SlightRecoil/Werkstatten-Sommerprojekt/Documentation/timeline.tex

\documentclass{article}
\usepackage{graphicx}
\begin{document}
This is where im going to save what happened when
25.02.2025: personel allocation was divised, schedule was made, components were found, started drawing circuit
\end{document}
