SlightRecoil/Werkstatten-Sommerprojekt/Documentation/images/helmet1.png

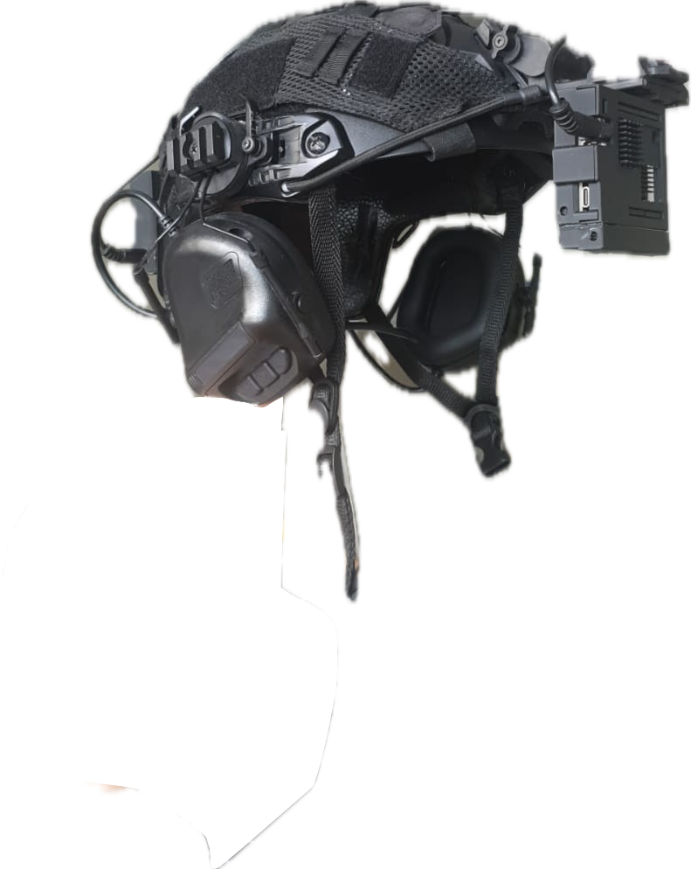
Documentation/images/helmet1.png
