SlightRecoil/Werkstatten-Sommerprojekt/Documentation/images/helmet2.png

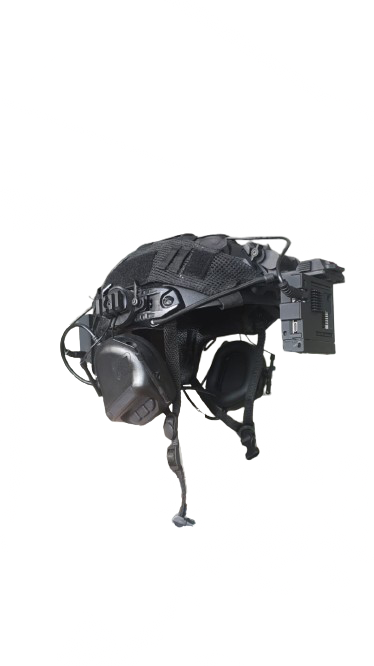
Documentation/images/helmet2.png
