SlightRecoil/Werkstatten-Sommerprojekt/Documentation/images/helmet3.png

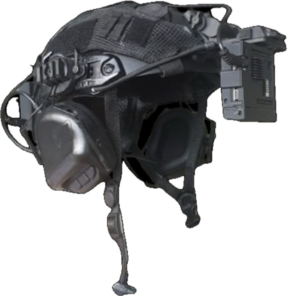
Documentation/images/helmet3.png
