SlightRecoil/Werkstatten-Sommerprojekt/Documentation/images/helmet_bg.jpeg

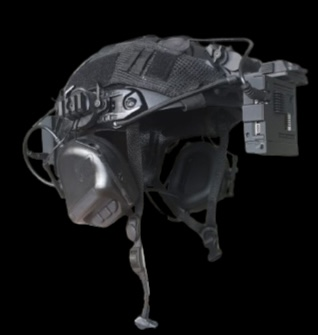
Documentation/images/helmet_bg.jpeg
