SlightRecoil/Werkstatten-Sommerprojekt/Documentation/images/main.png

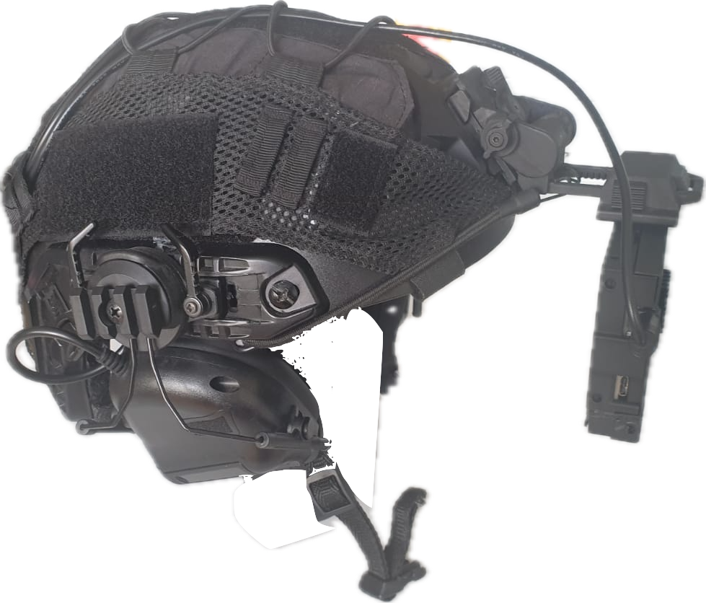
Documentation/images/main.png
