SlightRecoil/Werkstatten-Sommerprojekt/Documentation/m1 subcircuit.png

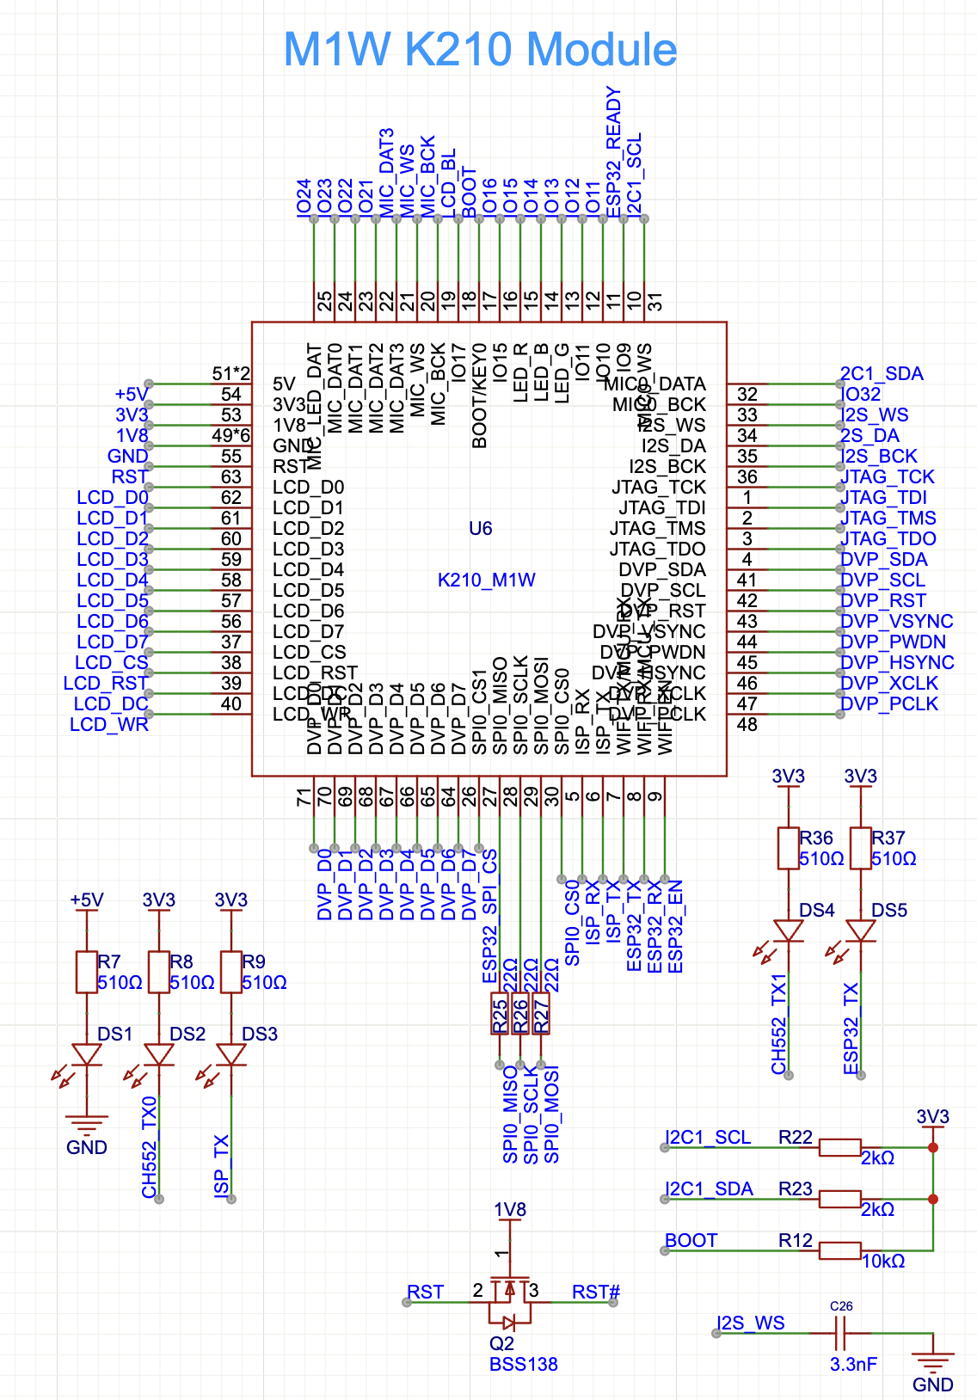
Documentation/m1 subcircuit.png
