SlightRecoil/Werkstatten-Sommerprojekt/PCB/DNOD_BOM.xlsx

No. | Quantity | Comment | Designator | Footprint | Value | Manufacturer Part | Manufacturer | Supplier Part | Supplier
1 | 2 | 100nF | C1,C8 | C0402 | 100nF | CL05B104KO5NNNC | SAMSUNG(三星) | C1525 | LCSC
2 | 2 | 22uF | C2,C13 | CAP-SMD_BD5.0-L5.3-W5.3-FD | 22uF | RVE1E220M0505 | HONOR(荣誉) | C88661 | LCSC
3 | 6 | 100nF | C4,C9,C10,C12,C20,C22 | C0603 | 100nF | CGA0603X7R104K500JT | HRE(芯声) | C6119867 | LCSC
4 | 1 | 10nF | C5 | C0402 | 10nF | CC0402KRX7R9BB103 | YAGEO(国巨) | C60133 | LCSC
5 | 1 | 10uF | C6 | C0805 | 10uF | CL21A106KAYNNNE | SAMSUNG(三星) | C15850 | LCSC
6 | 3 | 22uF | C7,C18,C19 | C0603 | 22uF | CL10A226MQ8NRNC | SAMSUNG(三星) | C59461 | LCSC
7 | 1 | 22uF | C11 | C0603 | 22uF | CL10A226MP8NUNE | SAMSUNG(三星) | C86295 | LCSC
8 | 2 | 10uF | C15,C21 | C0603 | 10uF | CGA0603X5R106K100JT | HRE(芯声) | C6119842 | LCSC
9 | 2 | 18pF | C16,C17 | C0402 | 18pF | FCC0402N180J500AT | FOJAN(富捷) | C5137554 | LCSC
10 | 1 | 3.3nF | C23 | C0402 | 3.3nF | CC0402KRX7R9BB332 | YAGEO(国巨) | C107028 | LCSC
11 | 2 | 10uF | C24,C25 | CAP-SMD_BD6.3-L6.6-W6.6-LS7.2-FD | 10uF | RVT2A100M0607 | HONOR(荣誉) | C86606 | LCSC
12 | 1 | GPIOs | CN1 | FPC-SMD_KH-FG0.5-H2.0-24PIN |  | KH-FG0.5-H2.0-24PIN | kinghelm(金航标) | C2797213 | LCSC
13 | 1 | LCD | CN2 | FPC-SMD_KH-FG0.5-H2.0-24PIN |  | KH-FG0.5-H2.0-24PIN | kinghelm(金航标) | C2797213 | LCSC
14 | 1 | Camera | CN3 | FPC-SMD_KH-FG0.5-H2.0-24PIN |  | KH-FG0.5-H2.0-24PIN | kinghelm(金航标) | C2797213 | LCSC
15 | 2 | DSK24 | D1,D2 | SOD-123FL_L2.7-W1.8-LS3.8-RD |  | DSK24 | TWGMC(台湾迪嘉) | C727073 | LCSC
16 | 5 | XL-1608SURC-06 | DS1,DS2,DS3,DS4,DS5 | LED0603-RD_RED |  | XL-1608SURC-06 | XINGLIGHT(成兴光) | C965799 | LCSC
17 | 1 | MF-NSMF200-2 | F1 | F1206 |  | MF-NSMF200-2 | BOURNS | C89656 | LCSC
18 | 1 | M6027-01 | J1 | TF-SMD_M6027-01 |  | M6027-01 | MUP(德海威) | C20624804 | LCSC
19 | 1 | DC-005-2.0 | J2 | DC-IN-TH_DC-005-2.0_C22459640 |  | DC-005-2.0 | HanElectricity(瀚源) | C22459640 | LCSC
20 | 1 | 6.8uH | L1 | IND-SMD_L2.5-W2.0_YXMBL252010P | 6.8uH | FTC252012S6R8MBCA | cjiang(长江微电) | C5832375 | LCSC
21 | 1 | AO3401A | Q1 | SOT-23-3_L2.9-W1.6-P1.90-LS2.8-BR |  | AO3401A | ElecSuper(静芯微) | C5224202 | LCSC
22 | 1 | BSS138 | Q2 | SOT-23_L2.9-W1.3-P1.90-LS2.4-BR |  | BSS138 | JUXING(钜兴) | C5279927 | LCSC
23 | 6 | 10kΩ | R1,R2,R5,R6,R16,R17 | R0603 | 10kΩ | FRC0603J103TS | FOJAN(富捷) | C2930027 | LCSC
24 | 2 | 1kΩ | R3,R10 | R0402 | 1kΩ | 0402WGF1001TCE | UNI-ROYAL(厚声) | C11702 | LCSC
25 | 1 | 39Ω | R4 | R0402 | 39Ω | RC0402FR-0739RL | YAGEO(国巨) | C185420 | LCSC
26 | 1 | 68kΩ | R7 | R0402 | 68kΩ | RC0402FR-0768KL | YAGEO(国巨) | C137947 | LCSC
27 | 1 | 13kΩ | R8 | R0402 | 13kΩ | RC0402FR-0713KL | YAGEO(国巨) | C138057 | LCSC
28 | 1 | 1.4kΩ | R9 | R0402 | 1.4kΩ | RC-02W1401FT | FH(风华) | C290101 | LCSC
29 | 2 | 1kΩ | R11,R13 | R0402 | 1kΩ | RC0402FR-071KL | YAGEO(国巨) | C106235 | LCSC
30 | 4 | 2kΩ | R12,R14,R18,R21 | R0402 | 2kΩ | RC0402FR-072KL | YAGEO(国巨) | C60488 | LCSC
31 | 1 | 5R3 | R15 | R0603 | 10K
32 | 5 | 510Ω | R19,R20,R22,R23,R24 | R0603 | 510Ω | FRC0603J511 TS | FOJAN(富捷) | C2907179 | LCSC
33 | 6 | 22Ω | R25,R26,R27,R28,R29,R31 | R0402 | 22Ω | RC0402FR-0722RL | YAGEO(国巨) | C114765 | LCSC
34 | 2 | 2kΩ | R30,R32 | R0603 | 2kΩ | 0603WAF2001T5E | UNI-ROYAL(厚声) | C22975 | LCSC
35 | 1 | 10kΩ | R33 | R0603 | 10kΩ | 0603WAF1002T5E | UNI-ROYAL(厚声) | C25804 | LCSC
36 | 1 | NC | R34 | R0603 | 10kΩ | 0603WAF1002T5E | UNI-ROYAL(厚声) | C25804 | LCSC
37 | 1 | 5.1kΩ | R36 | R0402 | 5.1kΩ | 0402WGF5101TCE | UNI-ROYAL(厚声) | C25905 | LCSC
38 | 2 | TS-1088R-02026 | SW1,SW2 | SW-SMD_L3.9-W3.0-P4.45 |  | TS-1088R-02026 | XUNPU(讯普) | C455280 | LCSC
39 | 1 | PT8211-S | U1 | SOP-8_L4.9-W3.9-P1.27-LS6.0-BL |  | PT8211-S | PTC(普诚) | C92004 | LCSC
40 | 1 | LM321 | U2 | SOT-23-5_L3.0-W1.7-P0.95-LS2.8-BL |  | LM321 | PJSEMI(平晶微) | C686636 | LCSC
41 | 2 | AMS1117-ADJ | U3,U6 | SOT-223-3_L6.5-W3.4-P2.30-LS7.0-BR |  | AMS1117-ADJ | YONGYUTAI(永裕泰) | C2891840 | LCSC
42 | 1 | EUP3458VIR1 | U4 | SOT-23-6_L2.9-W1.6-P0.95-LS2.8-BL |  | EUP3458VIR1 | EUTECH(德信) | C89300 | LCSC
43 | 1 | XC6206-3.3V | U5 | SSOT-3_L2.9-W1.6-P0.95-LS2.8-BR |  | XC6206-3.3V | YONGYUTAI(永裕泰) | C2891841 | LCSC
44 | 1 | CH552T | U7 | TSSOP-20_L6.5-W4.4-P0.65-LS6.4-BL |  | CH552T | WCH(南京沁恒) | C111367 | LCSC
45 | 1 | 24MHz | U8 | XTAL_ABM8-24.000MHZ-B2-T
46 | 1 | K210_M1W | U9 | K210_M1W
47 | 1 | AMS1117-3.3 | U10 | SOT-223-3_L6.5-W3.4-P2.30-LS7.0-BR |  | AMS1117-3.3 | YONGYUTAI(永裕泰) | C2891839 | LCSC
48 | 1 | 42pF | U12 | SOT-563_L1.6-W1.2-P0.50-LS1.6-TL | 42pF | NUF2042XV6T1G | onsemi(安森美) | C90707 | LCSC
49 | 1 | ESP32-WROOM-32U-N4 | U20 | WIFI-SMD_ESP32-WROOM-32UE-A |  | ESP32-WROOM-32U-N4 | ESPRESSIF(乐鑫) | C2934572 | LCSC
50 | 1 | TYPE-C16PIN | USB1 | USB-C-SMD_TYPE-C16PIN |  | TYPE-C16PIN | SHOU HAN(首韩) | C393939 | LCSC
