SlightRecoil/Werkstatten-Sommerprojekt/PCB/DNOD_Gerber/How-to-order-PCB.txt

How to Order PCB

Please refer to:
https://prodocs.easyeda.com/en/pcb/order-order-pcb/index.html
