SlightRecoil/Werkstatten-Sommerprojekt/Documentation/designs/subcircuit.pdf

# M1W K210 Module

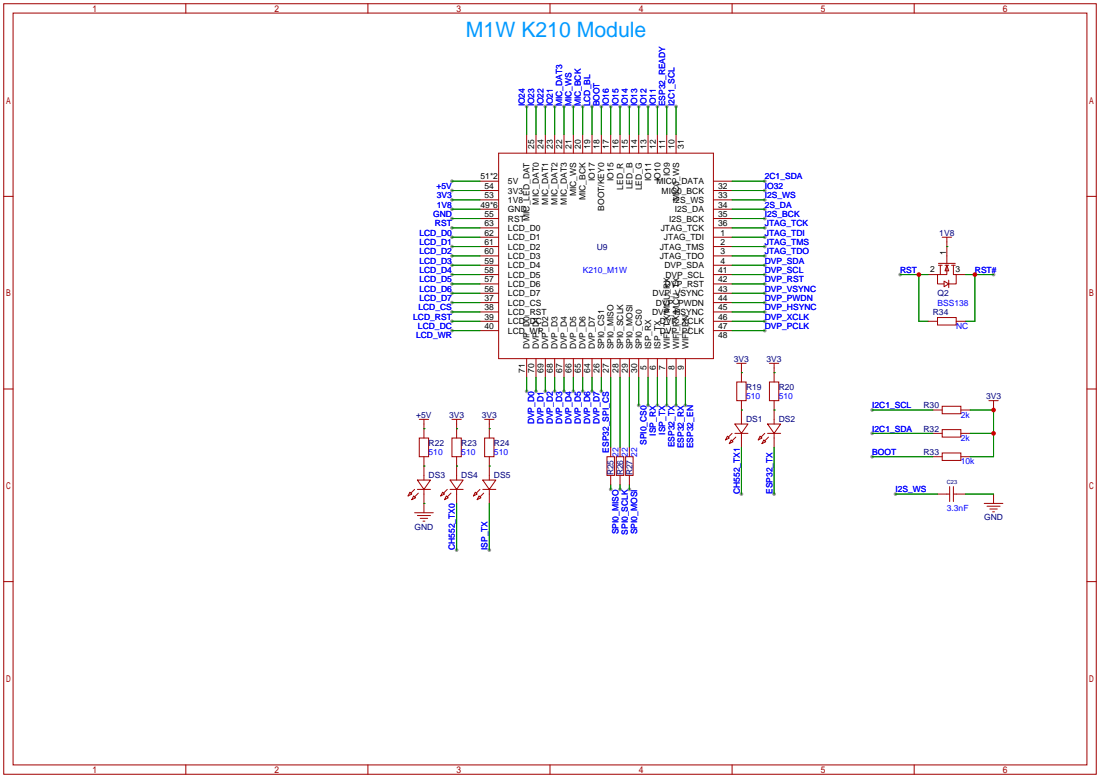
[picture p27: page 1]

# 8 Bit MCU LCD Connector

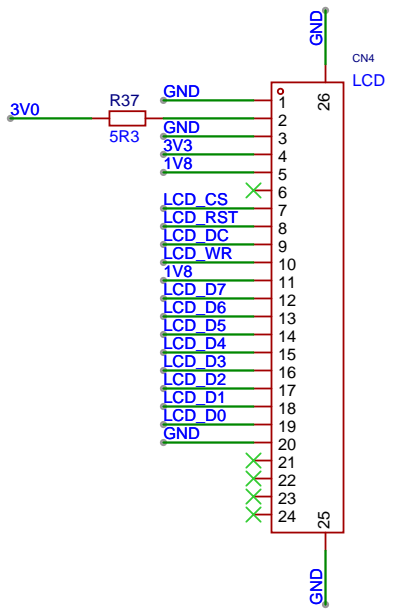
[picture p28: figure]
CN4 LCD; GND; GND 3V3 1V8; LCD_CS LCD_RST LCD_DC LCD_WR 1V8 LCD_D7 LCD_D6 LCD_D5 LCD_D4 LCD_D3 LCD_D2 LCD_D1 LCD_D0 GND; GND GND
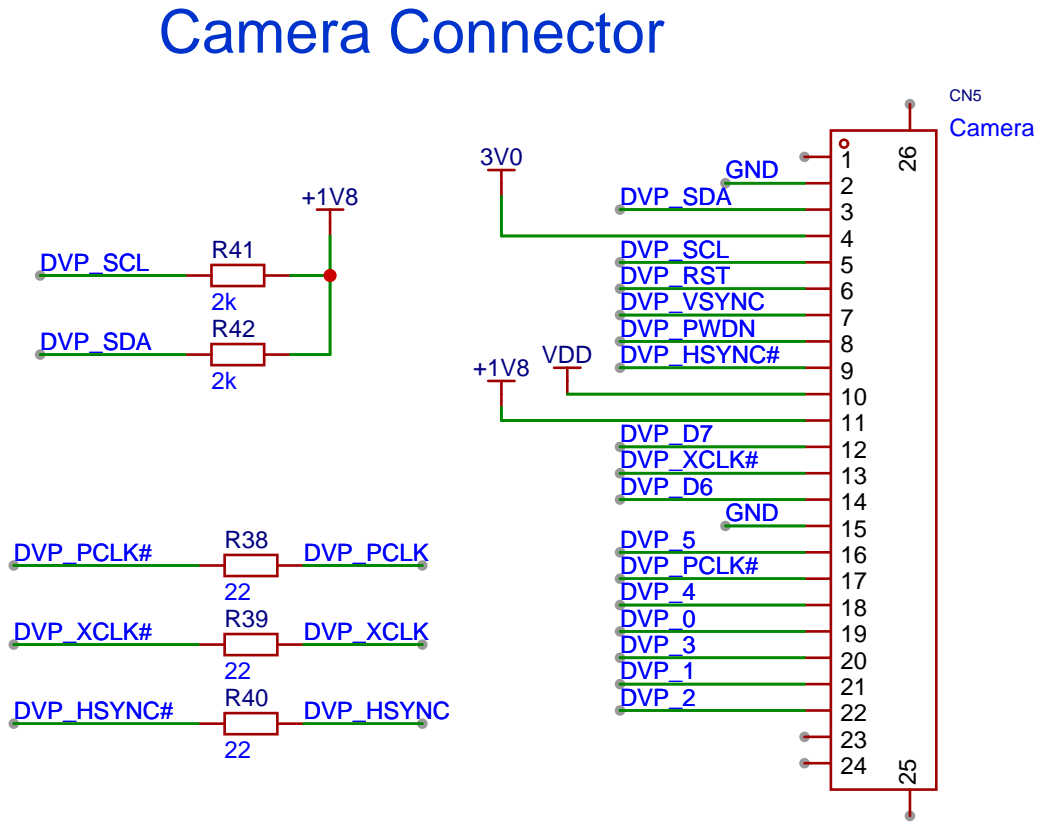
[picture p29: page 3]

# USB-C Port

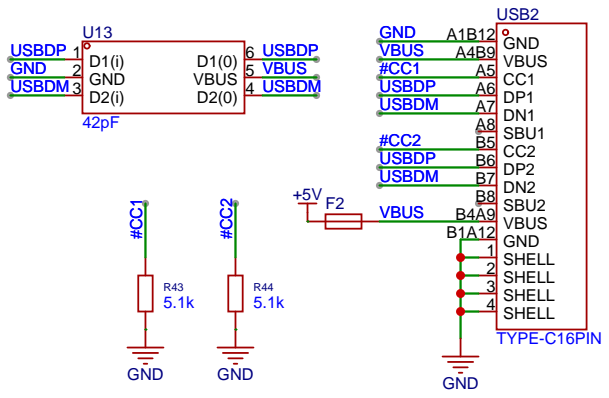
[picture p30: figure]
GND A1B12 VBUS A4B9 CC1 A5 DP1 A6 DN1 A7 SBU1 A8 CC2 B5 DP2 B6 DN2 B7 SBU2 B8 VBUS B4A9 GND B1A12 SHELL 1 SHELL 2 SHELL 3 SHELL 4; USB2; TYPE-C16PIN; GND; USBDP USBDM; GND VBUS #CC1; #CC2 USBDP USBDM; VBUS; D1(i) 1 GND 2 D2(i) 3; VBUS 5; USBDP; USBDM

# GPIOs

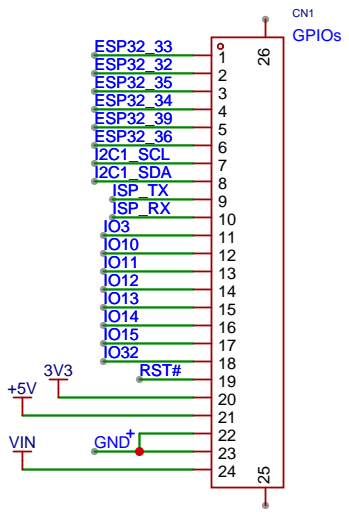
[picture p31: figure]
RST#; ESP32_33 ESP32_32 ESP32_35 ESP32_34 ESP32_39 ESP32_36 I2C1_SCL I2C1_SDA; ISP_TX ISP_RX; VIN; GND; CN1 GPIOs

# SD card slot

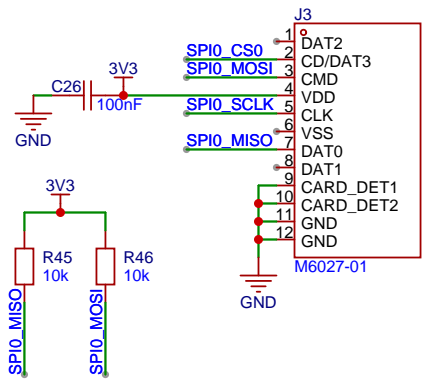
[picture p32: figure]
DAT2 1 CD/DAT3 2 CMD 3 VDD 4 CLK 5 VSS 6 DAT0 7 DAT1 8 CARD_DET1 9 CARD_DET2 10 GND 11 GND 12; SPI0_CS0 SPI0_MOSI; SPI0_SCLK; SPI0_MISO; SPI0_MOSI; GND
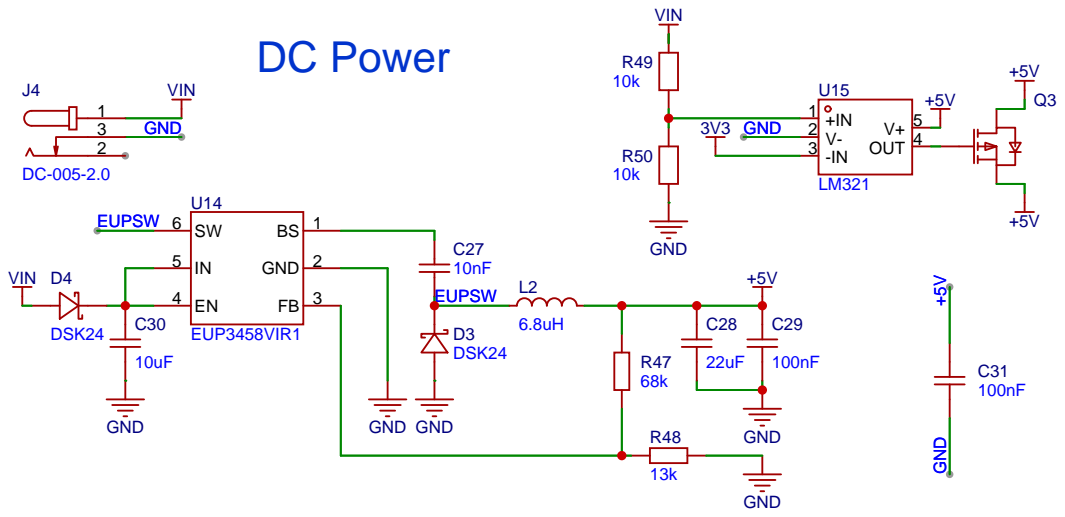
[picture p33: page 7]

# Camera Power

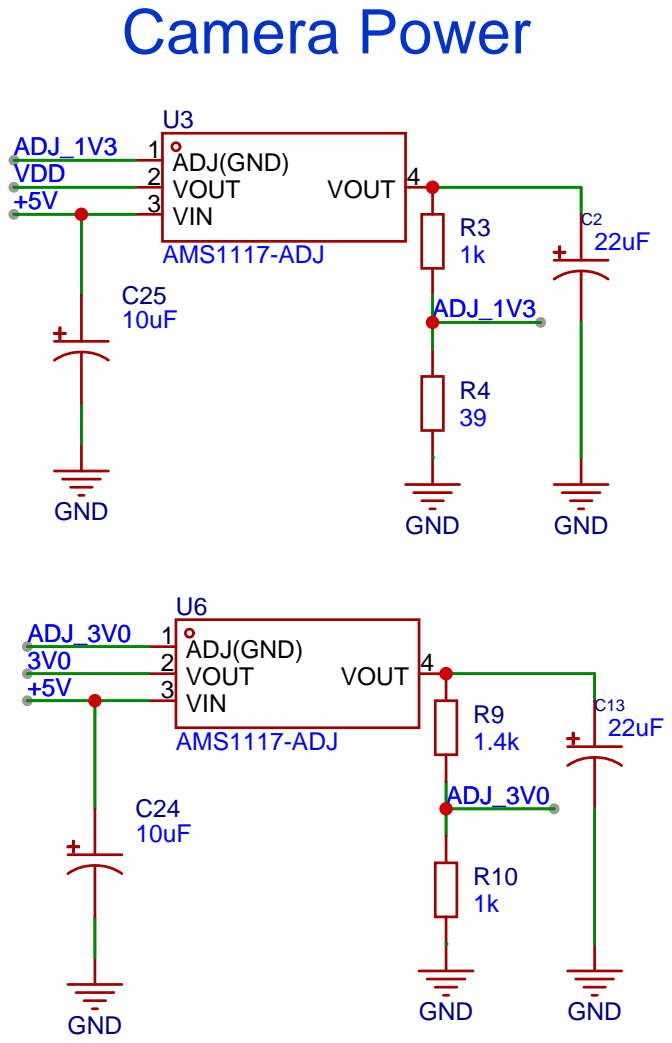
[picture p34: page 8]

# ISP Download

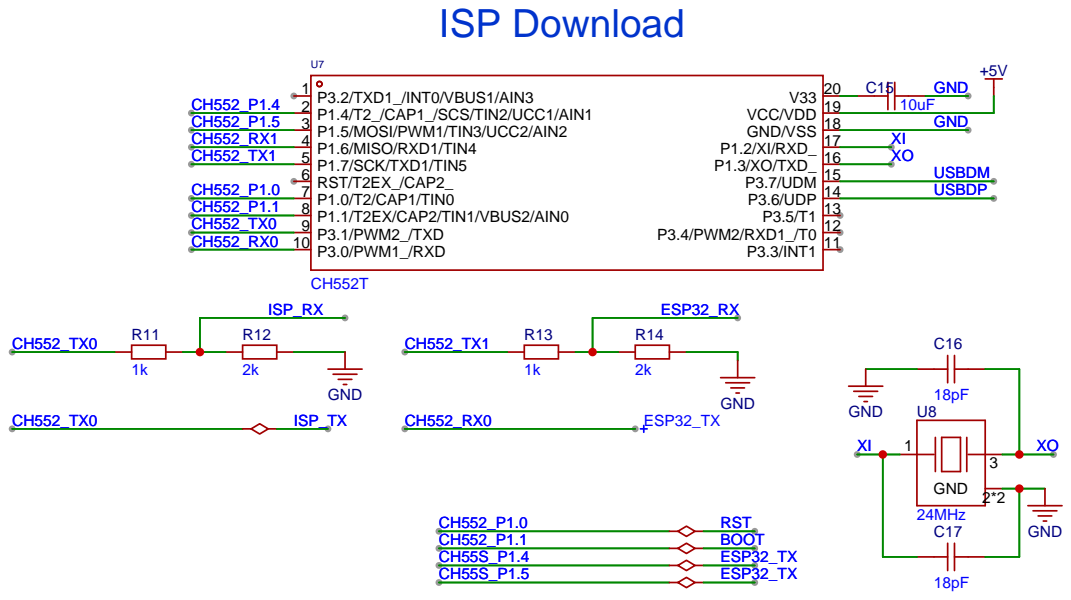
[picture p35: page 9]

BCK 1
WS 2
DIN 3
GND 4

VDD 5

LCH 6

NC 7

RCH 8

U16

PT8211-S

VSS 1
VOUT 2
VIN 3

U17

XC6206-3.3V

C32

100nF

C33
100nF

C34
100nF | C35
| 22uF

GND

3V3 +5V

GND

HPL

I2S_BCK
I2S_WS
I2S_DA

# DAC

# ESP32-WROOM-32

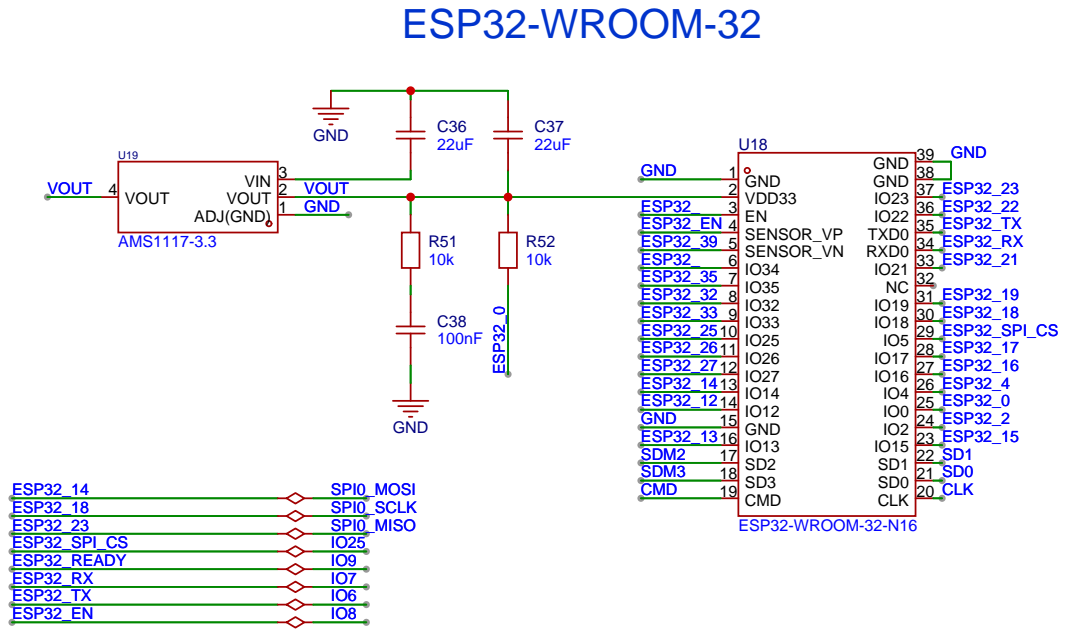
[picture p36: page 11]

1

2

SW3
1

2

SW4
RST | BOOT
GND | GND

# Key

C39
100nF

3V3 GND

C40
10uF

+5V GND
