SlightRecoil/Werkstatten-Sommerprojekt/Documentation/designs/pcb.pdf

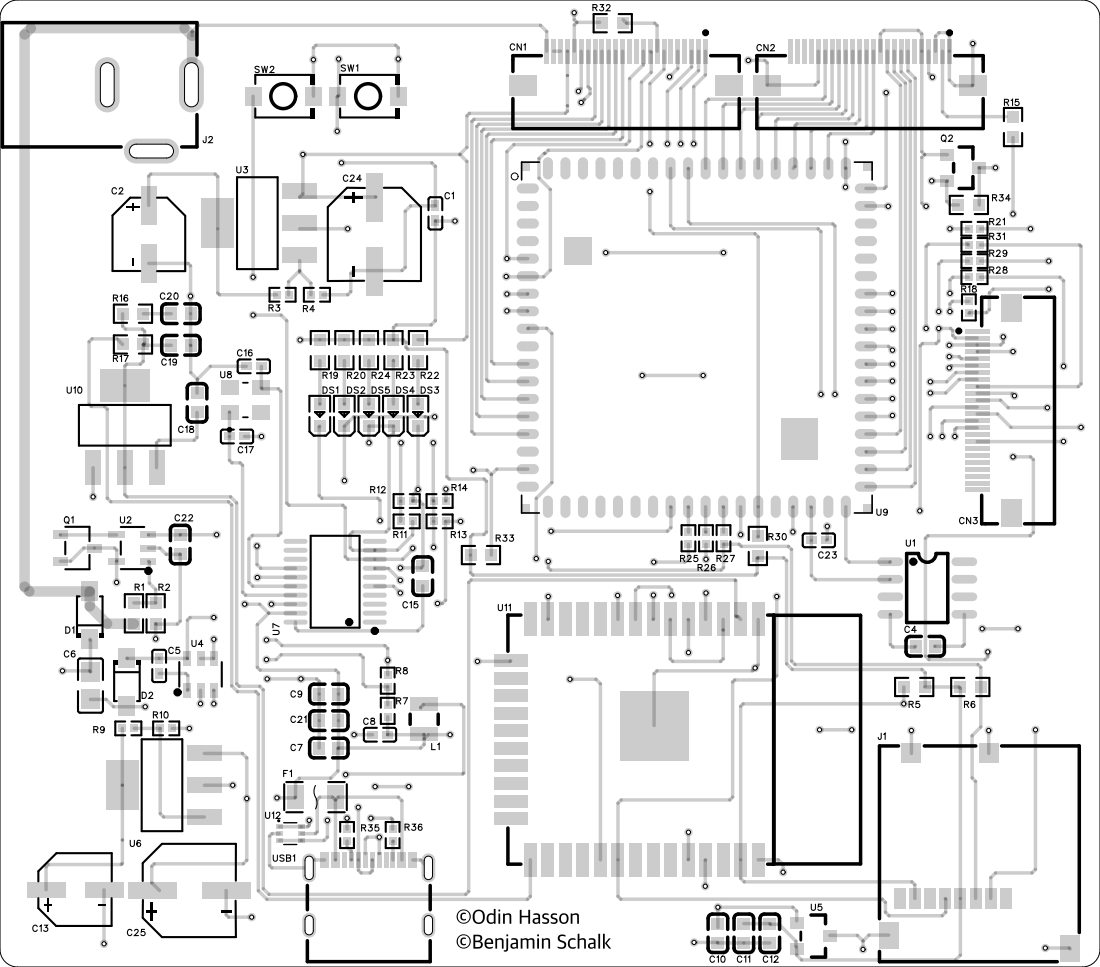
[picture p37: page 1]

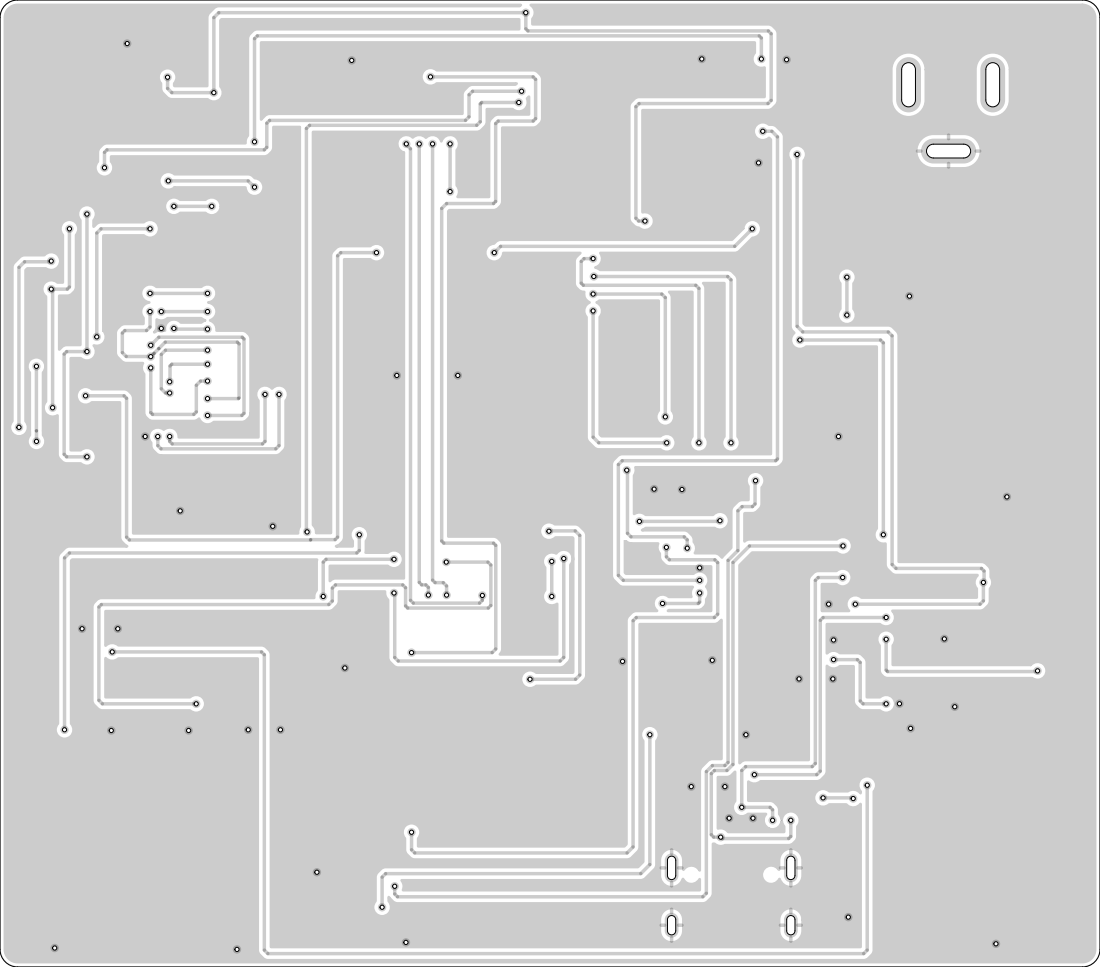
[picture p38: page 2]

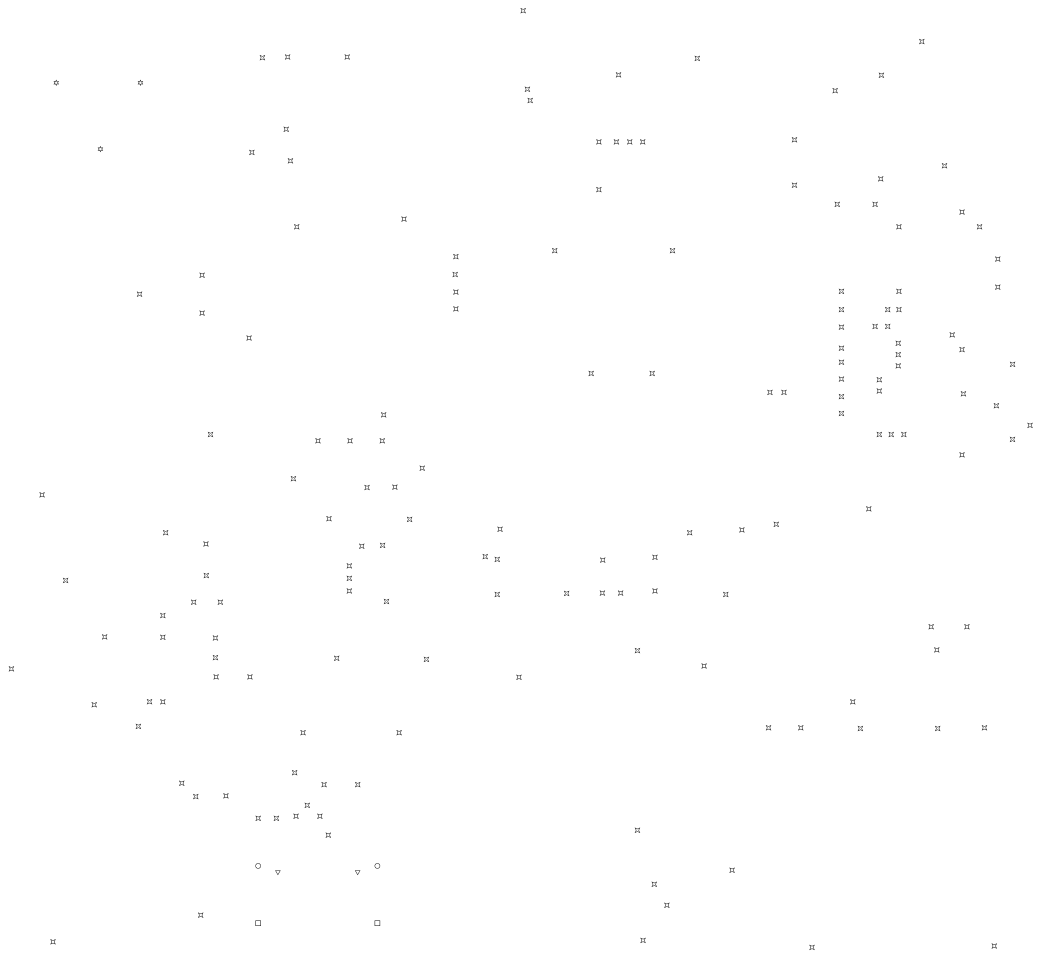
[picture p39: page 3]
