SlightRecoil/Werkstatten-Sommerprojekt/(list of files, drawings)

Other design files:
Digital_Night_Observation_Device.epro
